Mekaillzm/mastermind-control-logic-project/overall_circuit.jpeg

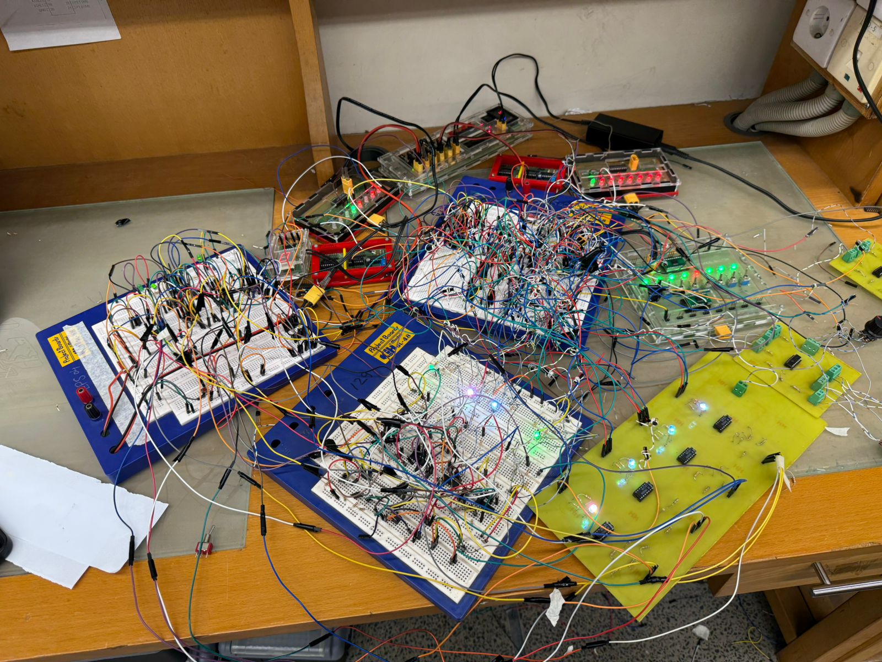
overall_circuit.jpeg
