Mekaillzm/mastermind-control-logic-project/(list of files, drawings)

Other design files:
simulation/final_simulation.pdsprj
